TimoRaab/LaserInterferenceLithography/README.md

# Laser Interference Lithography

Software and Hardware Files for Setting up the Laser interference lithography Setup described in the PhD Thesis "In-Situ Characterization of Film Formation in Solution-Processed Solar Cells" from Timo Raab, Universität Konstanz, 2022.
