TimoRaab/LaserInterferenceLithography/Hardware/SampleMounts/B_Mount/Specification.txt

B-Mount
14x14mm Sample
For BottomContacted with negative Resist
