TimoRaab/LaserInterferenceLithography/Hardware/SampleMounts/C_Mount/Specification.txt

C-Mount
14x14mm Sample
Usage with ND Filter for Transparent Substrate
