TimoRaab/LaserInterferenceLithography/Hardware/SampleMounts/A_Mount/MountA.PNG

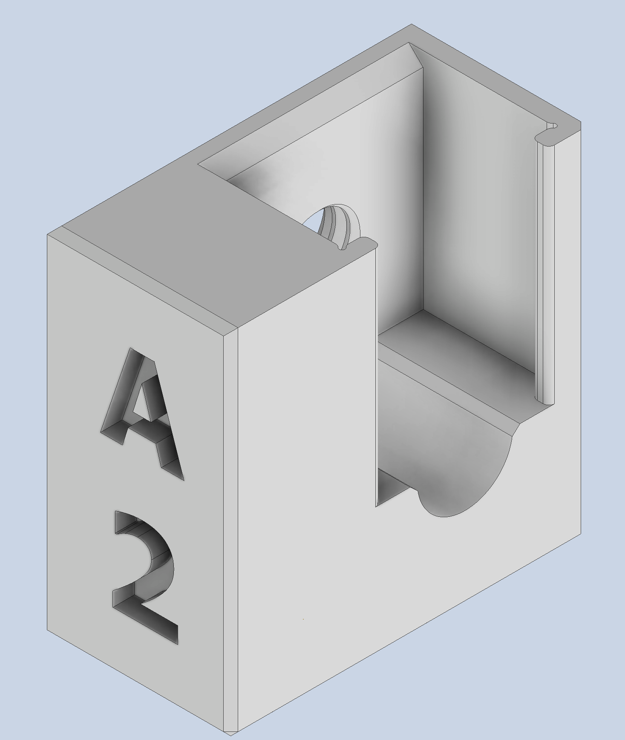
Hardware/SampleMounts/A_Mount/MountA.PNG
