TimoRaab/LaserInterferenceLithography/Hardware/SampleMounts/B_Mount/B_Mount_Part1.PNG

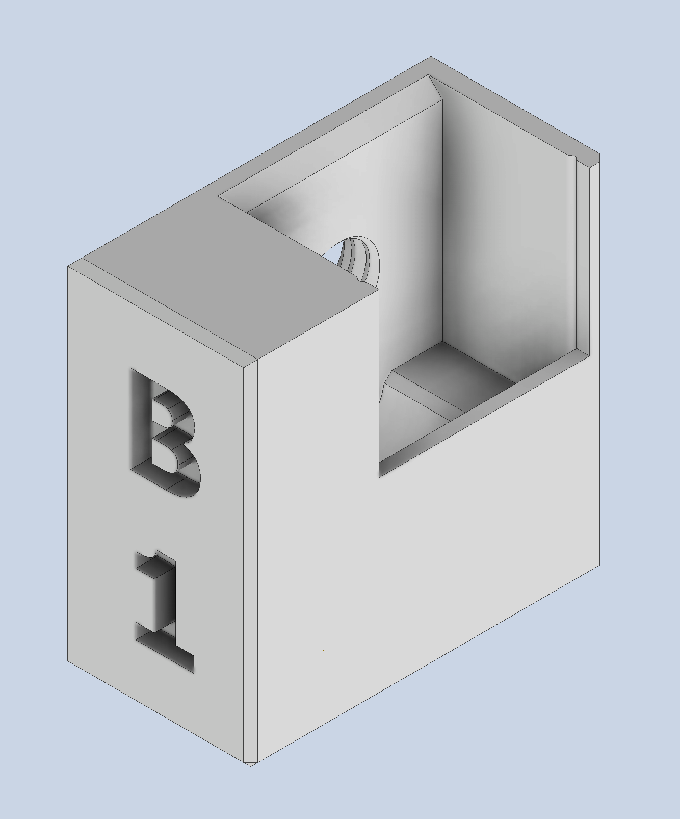
Hardware/SampleMounts/B_Mount/B_Mount_Part1.PNG
