TimoRaab/LaserInterferenceLithography/Hardware/SampleMounts/B_Mount/B_Mount_Part2.PNG

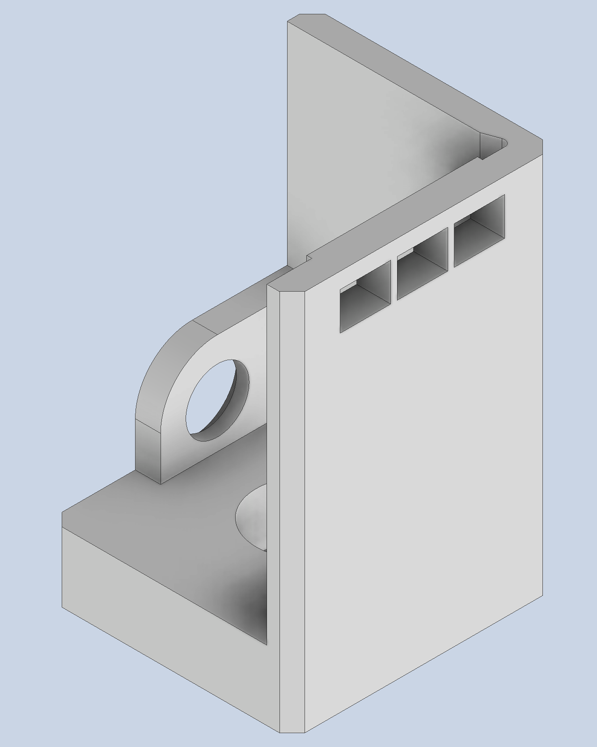
Hardware/SampleMounts/B_Mount/B_Mount_Part2.PNG
