TimoRaab/LaserInterferenceLithography/Hardware/SampleMounts/C_Mount/C_Mount.PNG

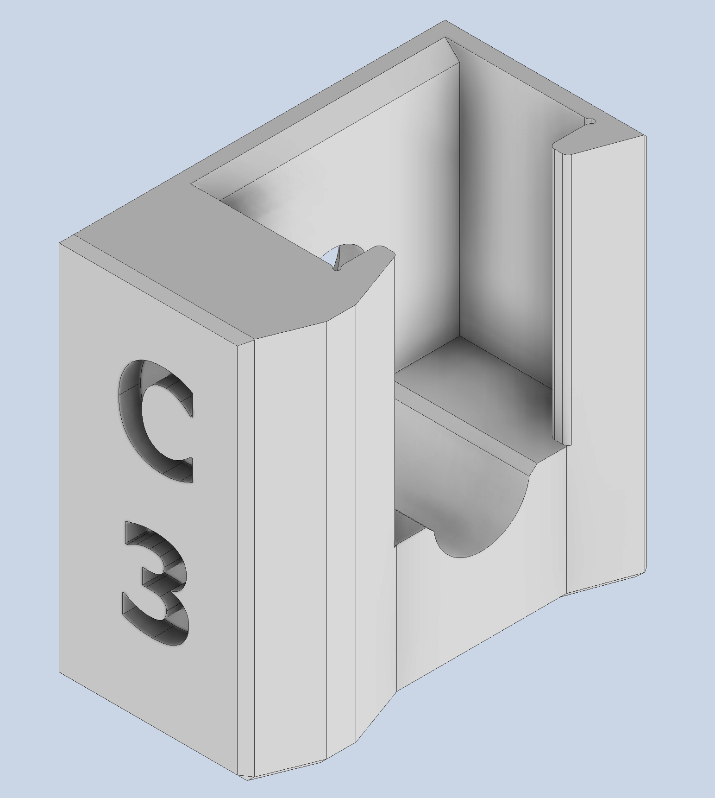
Hardware/SampleMounts/C_Mount/C_Mount.PNG
