TimoRaab/LaserInterferenceLithography/Hardware/MirrorSamplePackage/MirrorHolder.stp

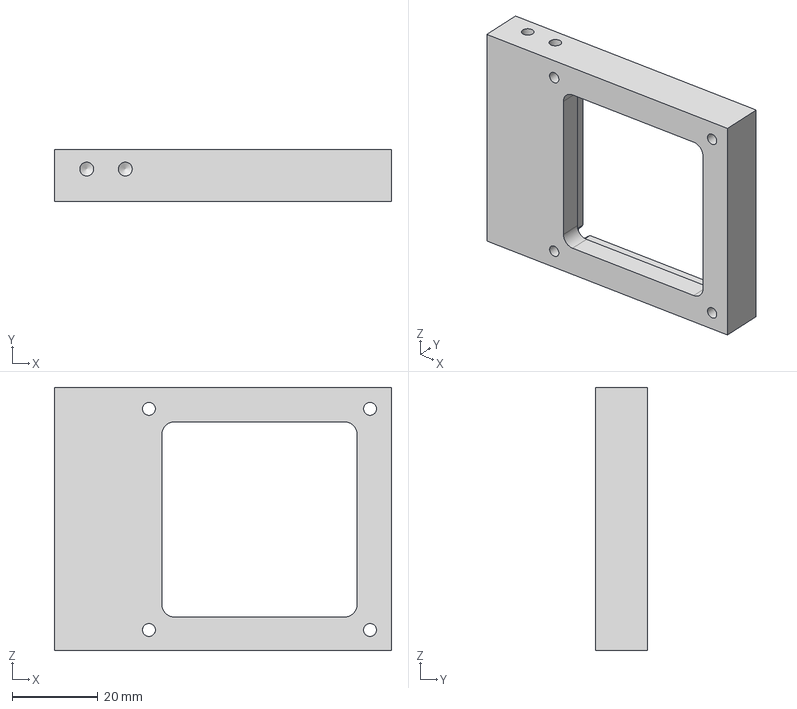
[picture p5: CAD file, 2022-12-04]
Hardware/MirrorSamplePackage/MirrorHolder.stp
78.5 x 12.0 x 61.3 mm
