TimoRaab/LaserInterferenceLithography/Hardware/SampleMounts/A_Mount/A_BackPlate_v01.stp

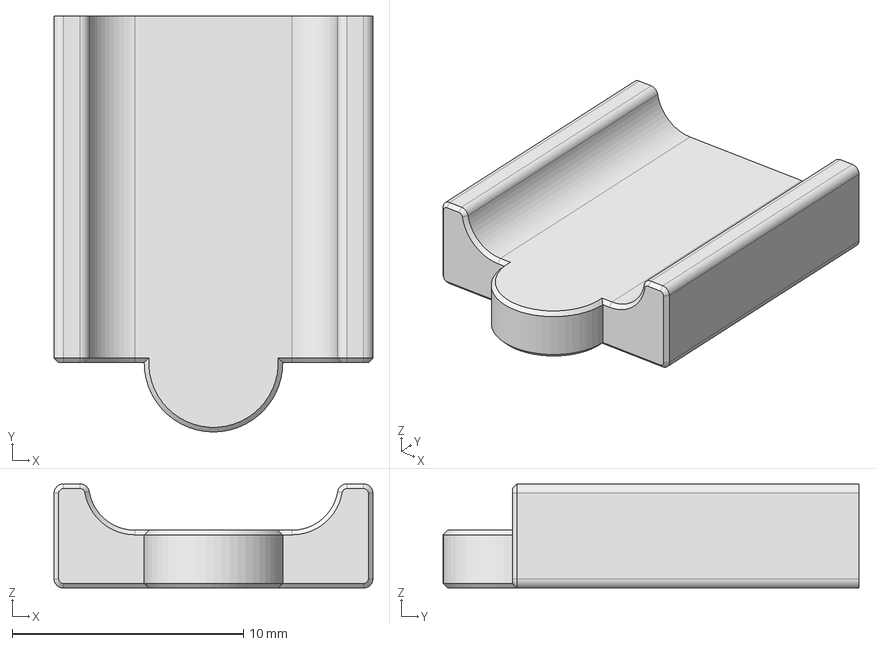
[picture p6: CAD file, 2022-12-04]
Hardware/SampleMounts/A_Mount/A_BackPlate_v01.stp
13.8 x 18.0 x 4.50 mm
