TimoRaab/LaserInterferenceLithography/Hardware/SampleMounts/B_Mount/B_SampleMount_v01.stp

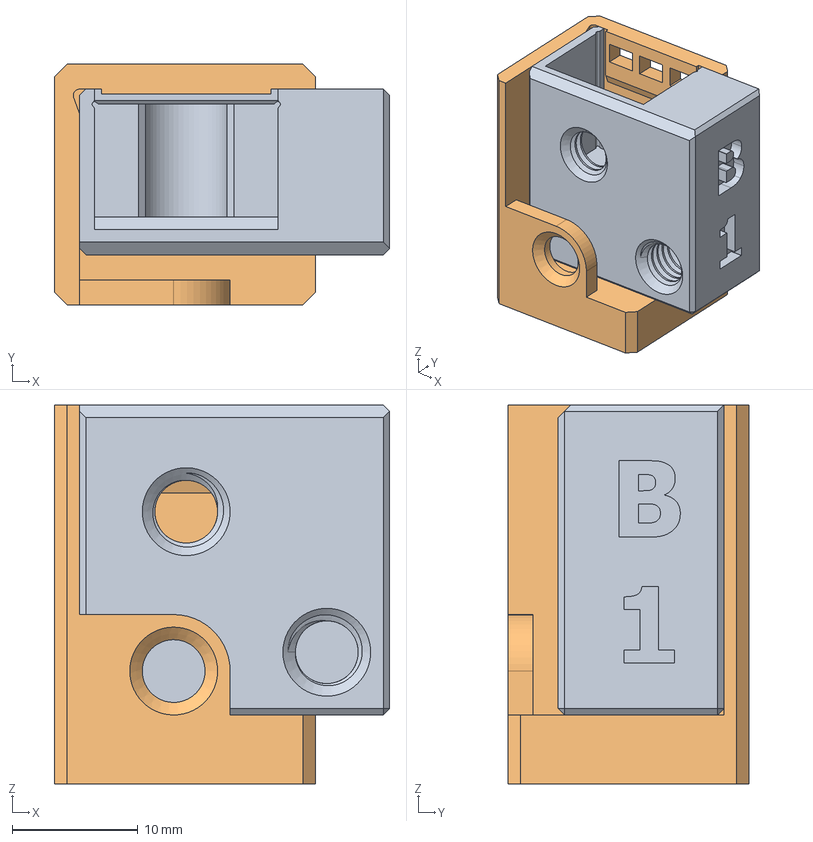
[picture p7: CAD file, 2022-12-04]
Hardware/SampleMounts/B_Mount/B_SampleMount_v01.stp
26.7 x 19.2 x 30.2 mm
