TimoRaab/LaserInterferenceLithography/Hardware/SampleMounts/C_Mount/C_BackPlate_v03.stp

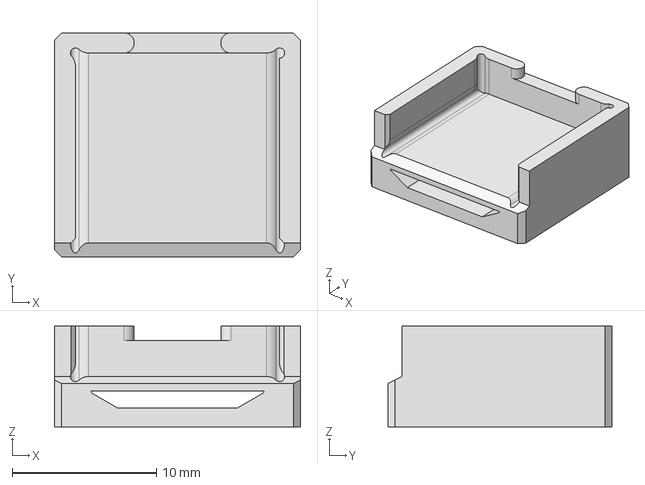
[picture p8: CAD file, 2022-12-04]
Hardware/SampleMounts/C_Mount/C_BackPlate_v03.stp
17.1 x 15.6 x 7.00 mm
