TimoRaab/LaserInterferenceLithography/Hardware/MirrorSamplePackage/SampleMountFingers.stp

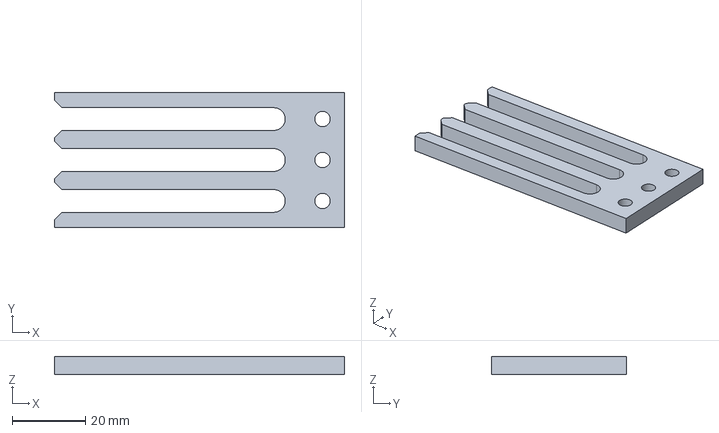
[picture p9: CAD file, 2022-12-04]
Hardware/MirrorSamplePackage/SampleMountFingers.stp
79.3 x 37.0 x 5.00 mm
