TimoRaab/LaserInterferenceLithography/Hardware/SampleMounts/C_Mount/C_SampleMount_v03_02.stp

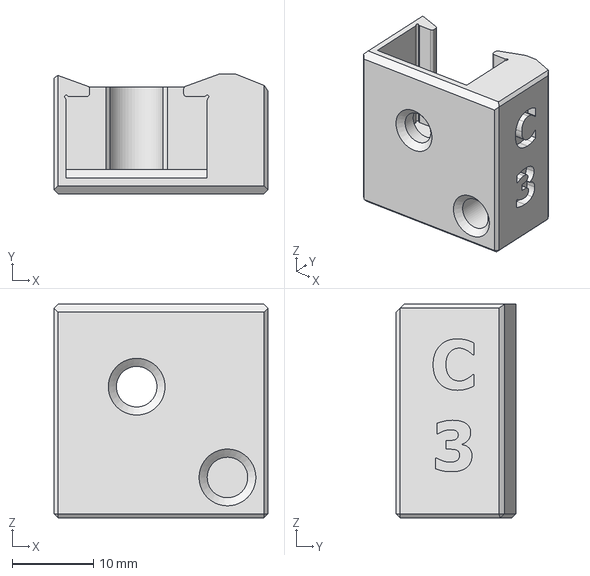
[picture p10: CAD file, 2022-12-04]
Hardware/SampleMounts/C_Mount/C_SampleMount_v03_02.stp
26.4 x 14.8 x 26.4 mm
