TimoRaab/LaserInterferenceLithography/Hardware/MirrorSamplePackage/StageConnection.stp

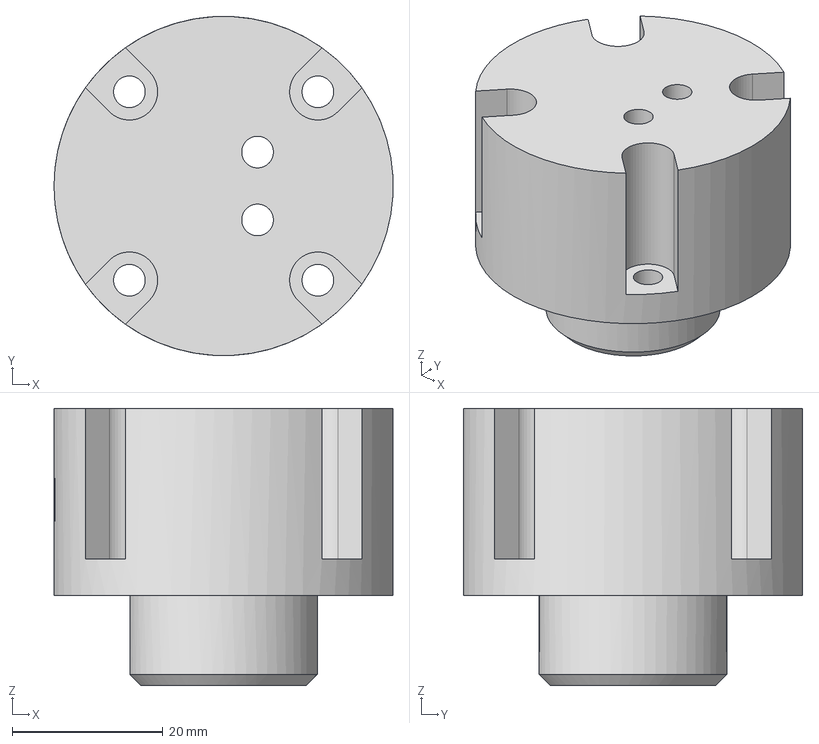
[picture p11: CAD file, 2022-12-04]
Hardware/MirrorSamplePackage/StageConnection.stp
45.0 x 45.0 x 36.8 mm
