TimoRaab/LaserInterferenceLithography/(list of files, cad)

Other CAD files:
Hardware/Interlock/EndSwitchHousing_v02.ipt
Hardware/Interlock/EndSwitchHousing_v02_TopPlate.ipt
Hardware/Interlock/EndSwitchMountingPlate_v02.ipt
Hardware/Interlock/InterlockBox.iam
Hardware/Interlock/StereoBuchseEinbau.ipt
Hardware/MirrorSamplePackage/MirrorHolder.ipt
Hardware/MirrorSamplePackage/SampleMountFingers.ipt
Hardware/MirrorSamplePackage/Sample_Mirror_Holder.iam
Hardware/MirrorSamplePackage/StageConnection.ipt
Hardware/SampleMounts/A_Mount/A_BackPlate_v01.ipt
Hardware/SampleMounts/A_Mount/A_SampleMount_v02.ipt
Hardware/SampleMounts/B_Mount/B_SampleMount_v01.ipt
Hardware/SampleMounts/C_Mount/C_BackPlate_v03.ipt
Hardware/SampleMounts/C_Mount/C_SampleMount_v03_02.ipt
