TimoRaab/LaserInterferenceLithography/Electronics/CircuitDiagram.pdf

# +5V +⁵V

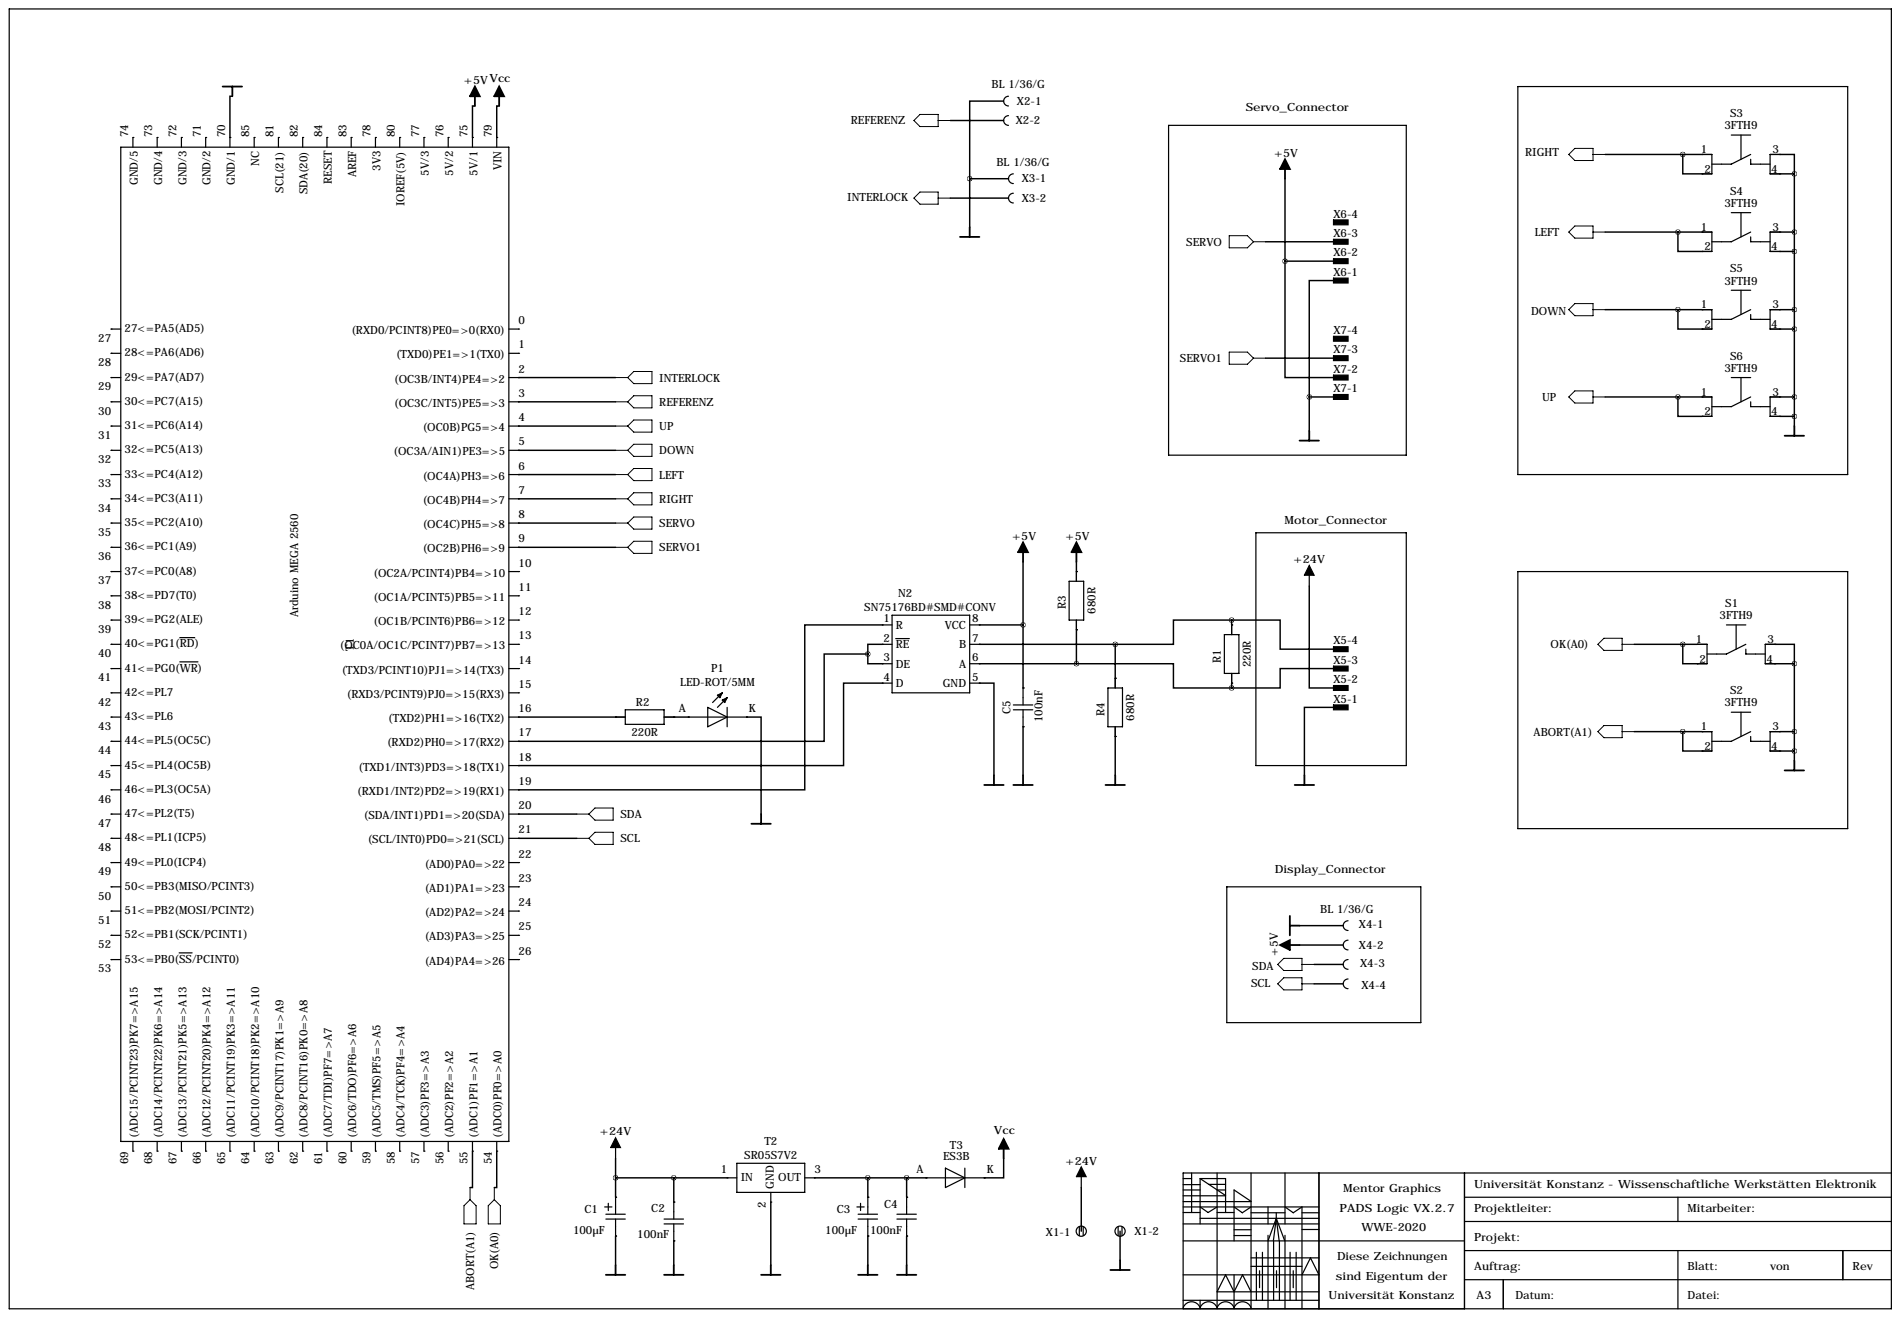
[picture p12: page 1]

19 | Display_Connector

53<=PB0(SS/PCINT0) 69 ⁽ADC¹5/PCINT23⁾PK7=>A¹⁵ 68 ⁽ADC¹4/PCINT22⁾PK6=>A¹⁴ 67 ⁽ADC¹3/PCINT21⁾PK⁵=>A¹³

Universität Konstanz - Wissenschaftliche Werkstätten Elektronik

Mentor Graphics PADS Logic VX.2.7 WWE-2020

Diese Zeichnungen sind Eigentum der Universität Konstanz

Auftrag: | Blatt: von | Rev

A3 | Datum: | Datei:
