TimoRaab/LaserInterferenceLithography/Electronics/PCB.pdf

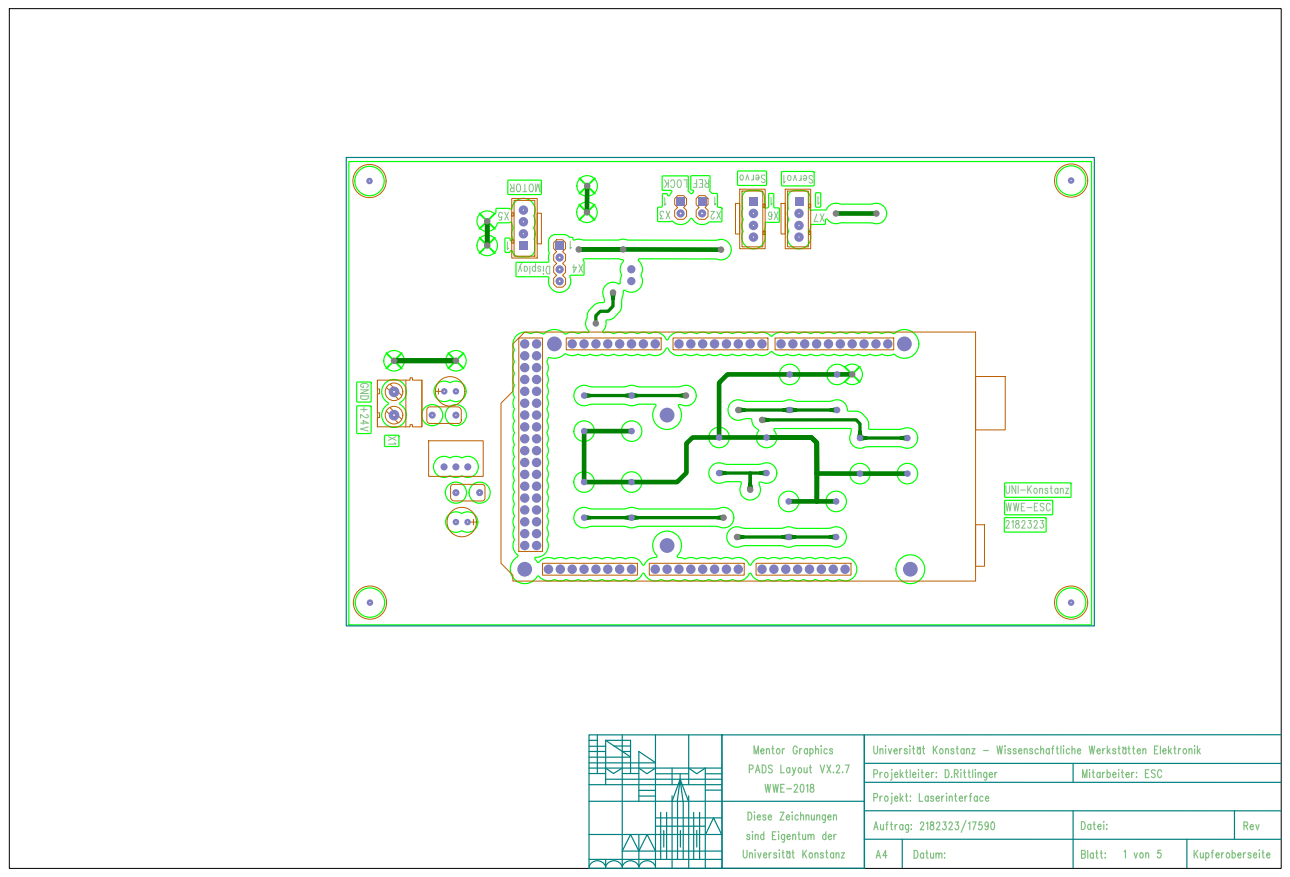
[picture p13: page 1]
1 von 5; Kupferoberseite; Datei:; Datum:; Auftrag: 2182323/17590; Blatt:; Rev; Projektleiter: D.Rittlinger; Mitarbeiter: ESC; +24V GND; UNI-Konstanz WWE-ESC 2182323; X1X¹x1 X¹x2; C1C¹x+; C¹x-; C2C²x2; C²x1 C3C³x⁻; C³x+; C4C⁴x1; C⁴x2; X2X²x1; X4X⁴x1 X⁴x2 X⁴x3 X⁴x4; X5X⁵x1 X⁵x2 X⁵x3 X⁵x4; P1P¹xA P¹xK; X6X⁶x1 X⁶x2 X⁶x3 X⁶x4; X7X⁷x1 X⁷x2 X⁷x3 X⁷x4; V1V¹x1; V2V²x1; V3V³x1; V4V⁴x1; S1S¹x2; S¹x1 S¹x4; S¹x3; S2S²x1; S²x2 S²x3; S²x4; S3S³x1; S³x2; S4S⁴x2; S⁴x1; S6S⁶x2; S⁶x1 S⁶x4; S⁶x3

Mentor Graphics
PADS Layout VX.2.7
WWE-2018

Universität Konstanz - Wissenschaftliche Werkstätten Elektronik
Projekt: Laserinterface

Diese Zeichnungen
sind Eigentum der
Universität Konstanz

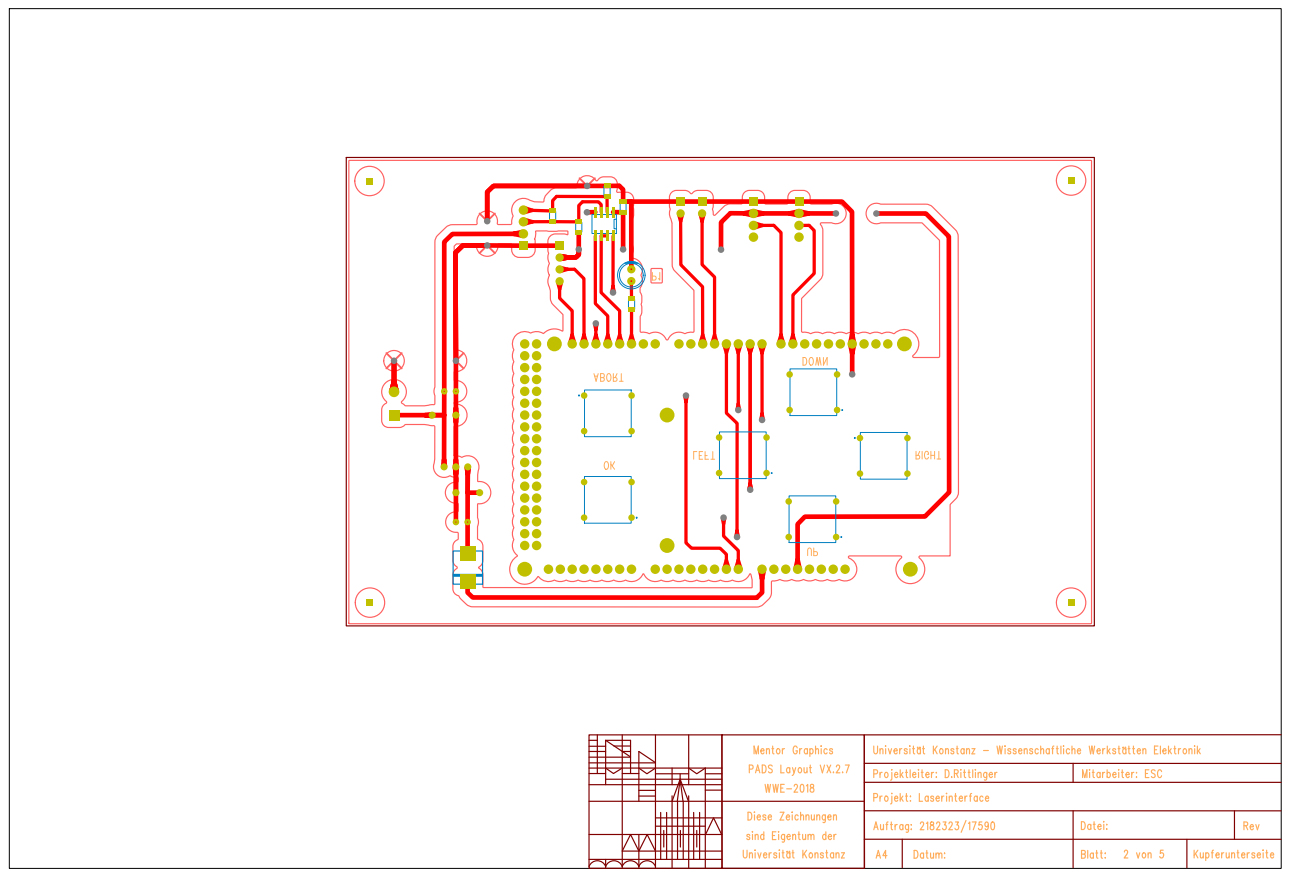
[picture p14: page 2]
2 von 5; Datei:; Datum:; Kupferunterseite; Auftrag: 2182323/17590; Blatt:; Rev; Projektleiter: D.Rittlinger; Mitarbeiter: ESC; DOWN; LEFT; RIGHT; ABORT; X1X¹x1 X¹x2; C1C¹x+; C¹x-; C2C²x2; C²x1 C3C³x⁻; C³x+; C4C⁴x1; C⁴x2; X2X²x1; X4X⁴x1 X⁴x2 X⁴x3 X⁴x4; X5X⁵x1 X⁵x2 X⁵x3 X⁵x4; R1R¹x1 R¹x2; R3R³x1 R³x2; R4R⁴x1 R⁴x2 N2N²x4; N²x3; N²x2; N²x1 N²x5; N²x6; N²x7; N²x8; C5C⁵x1 C⁵x2 R2R²x1 R²x2 P1P¹xA P¹xK; X6X⁶x1 X⁶x2 X⁶x3 X⁶x4; X7X⁷x1 X⁷x2 X⁷x3 X⁷x4; V1V¹x1; V2V²x1; V3V³x1; V4V⁴x1; S1S¹x2; S¹x1 S¹x4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

Mentor Graphics
PADS Layout VX.2.7
WWE-2018

Universität Konstanz - Wissenschaftliche Werkstätten Elektronik
Projekt: Laserinterface

Diese Zeichnungen
sind Eigentum der
Universität Konstanz

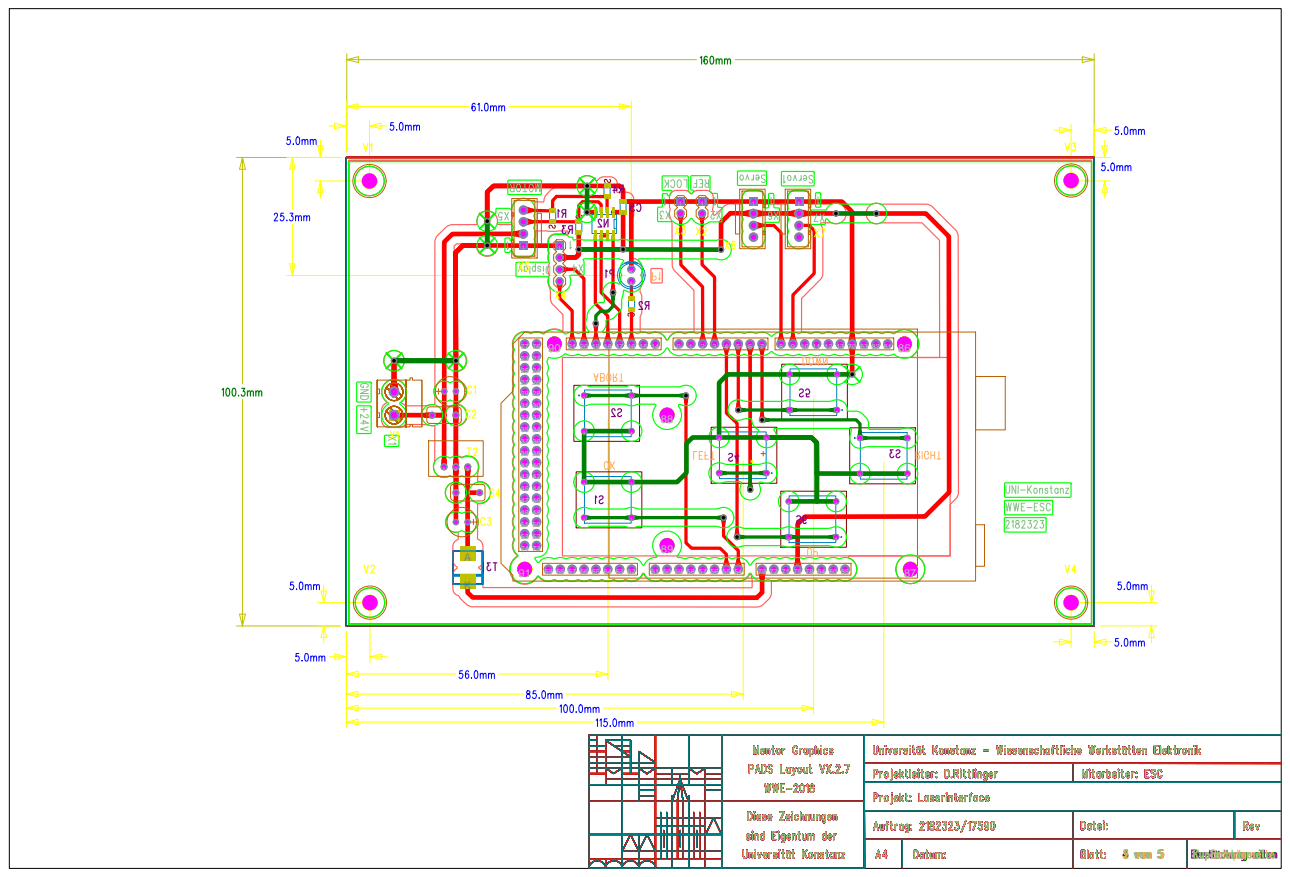
[picture p15: page 3]
Projekt: Laserinterface; Datei:; Datum:; Auftrag: 2182323/17590; Blatt:; Rev; Projektleiter: D.Rittlinger; Mitarbeiter: ESC; Mentor Graphics; Diese Zeichnungen; 4 von 5; Bestückung unten; 3 von 5; Bestückung oben; 5 von 5; Bohrplan; WWE-2018; 2 von 5; Kupferunterseite; DOWN; LEFT; RIGHT; ABORT; 1 von 5; Kupferoberseite; +24V GND; UNI-Konstanz WWE-ESC 2182323; X1X¹x1 X¹x2; C1C¹x+; C¹x-; C2C²x2; C²x1 C3C³x⁻; C³x+; C4C⁴x1; C⁴x2; X2X²x1; X4X⁴x1 X⁴x2 X⁴x3 X⁴x4; X5X⁵x1 X⁵x2 X⁵x3 X⁵x4; P1P¹xA P¹xK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

Mentor Graphics
PADS Layout VX.2.7

WWE-2018

Universität Konstanz - Wissenschaftliche Werkstätten Elektronik

sind Eigentum der
Universität Konstanz
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
