TimoRaab/LaserInterferenceLithography/Hardware/MirrorSamplePackage/Sample_Mirror_Holder.pdf

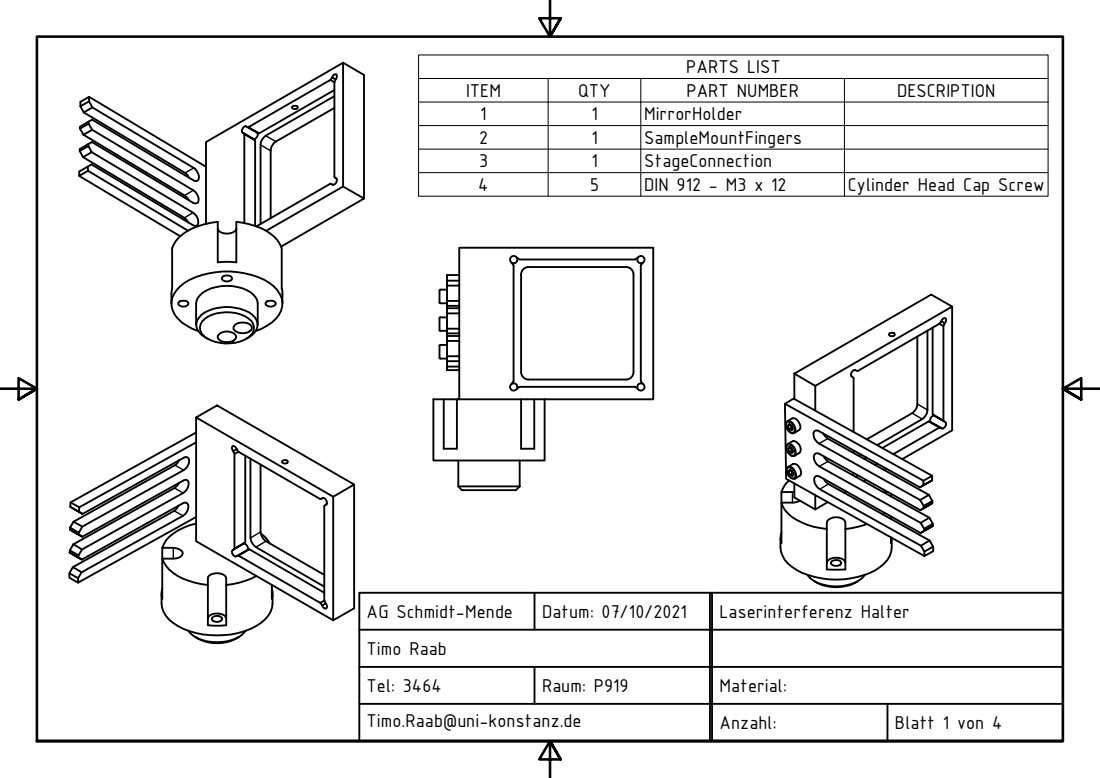
[picture p16: page 1]
PARTS LIST

ITEM | QTY | PART NUMBER | DESCRIPTION
1 | 1 | MirrorHolder
2 | 1 | SampleMountFingers
3 | 1 | StageConnection
4 | 5 | DIN 912 - M3 x 12 | Cylinder Head Cap Screw

AG Schmidt-Mende | Datum: 07/10/2021 | Laserinterferenz Halter

Timo Raab

Tel: 3464 | Raum: P919 | Material:

Timo.Raab@uni-konstanz.de | Anzahl: | Blatt 1 von 4

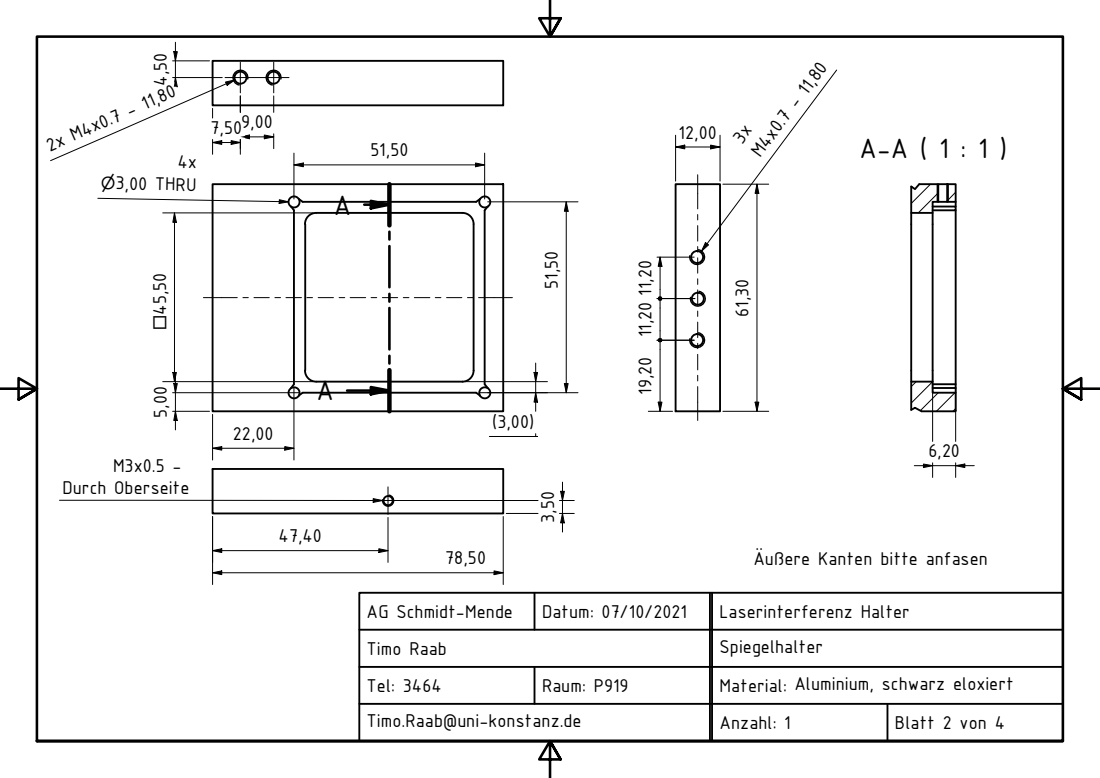
[picture p17: page 2]
⌀3,00 THRU; M3x0.5 - Durch Oberseite

Äußere Kanten bitte anfasen

AG Schmidt-Mende | Datum: 07/10/2021 | Laserinterferenz Halter

Timo Raab | | Spiegelhalter

Tel: 3464 | Raum: P919 | Material: Aluminium, schwarz eloxiert

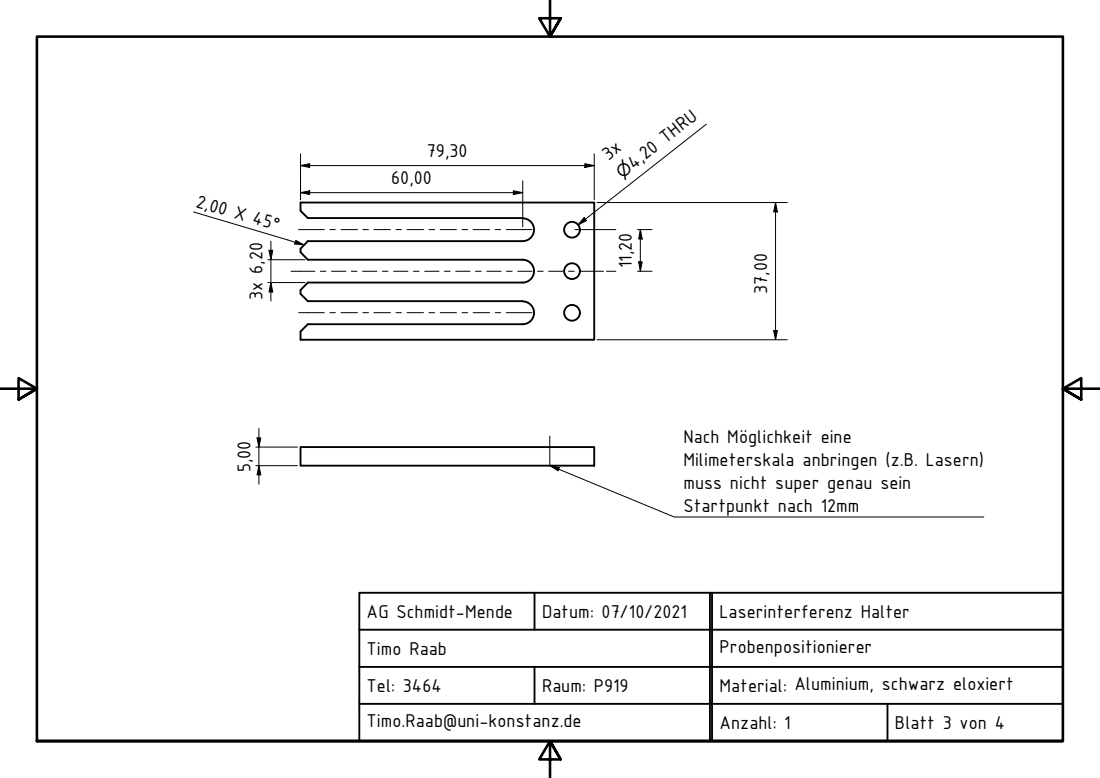
[picture p18: page 3]
⌀4,20 THRU

Nach Möglichkeit eine
Milimeterskala anbringen (z.B. Lasern)
muss nicht super genau sein
Startpunkt nach 12mm

AG Schmidt-Mende | Datum: 07/10/2021 | Laserinterferenz Halter

Timo Raab | | Probenpositionierer

Tel: 3464 | Raum: P919 | Material: Aluminium, schwarz eloxiert

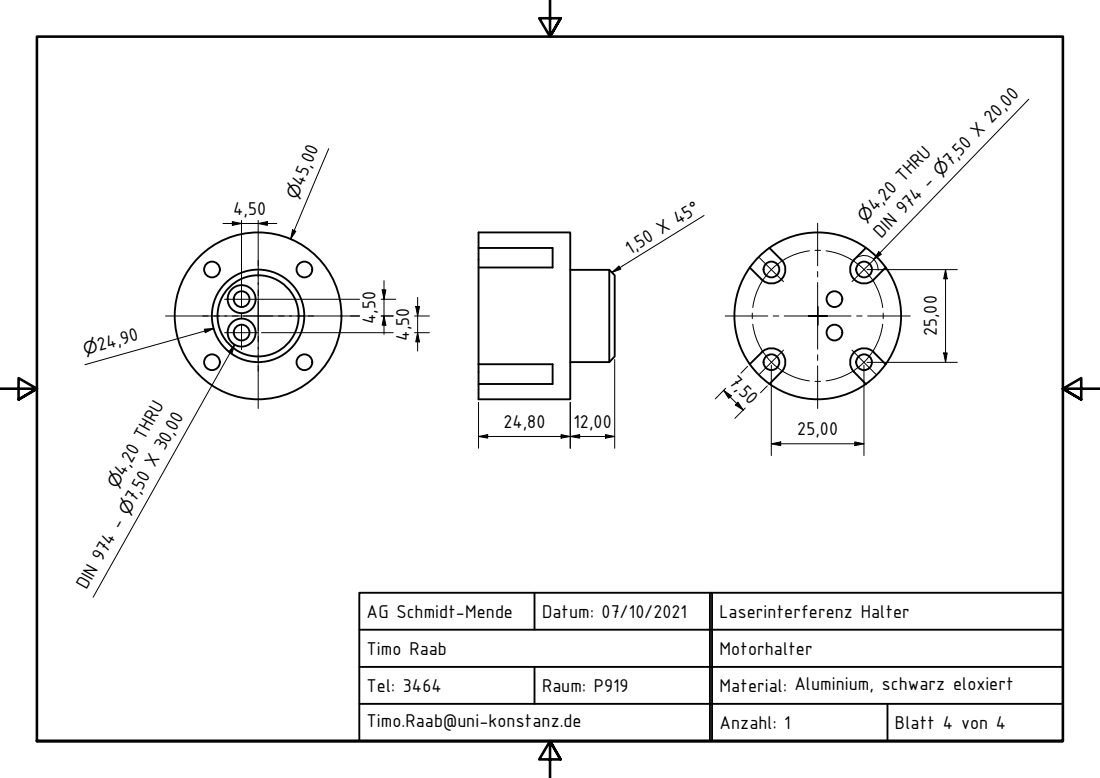
[picture p19: page 4]
⌀4,20 THRU; DIN 974 - ⌀7,50 X 20,00

AG Schmidt-Mende | Datum: 07/10/2021 | Laserinterferenz Halter

Timo Raab | | Motorhalter

Tel: 3464 | Raum: P919 | Material: Aluminium, schwarz eloxiert
